Fierobsessed84/EV_VCM_1/Fiero Tesla Wiring.xlsx

Sheet: Sheet1
Tesla Motor |  | With Open Inverter Logic Board | Proposed wiring
1 | IGN +12V |  | Switched IGN
2 | BRAKE ON |  | N/C
3 | PRECHARGE RELAY |  | Green #6 - on contactor box
4 | CAN HIGH |  | To VCU
5 | CAN LOW |  | To VCU
6 | MAIN CONTACTOR |  | White #7 - on contactor box
7 | FORWARD |  | N/C
8 | REVERSE |  | N/C
9 | ENC +5V |  | Red #4 on Encoder
10 | ENC A |  | White #2 on Encoder
11 | GND |  | Chassis GND
12 | ACCEL 5V |  | N/C
13 | ACCEL INPUT |  | N/C
14 | BRAKE TRANSDUCER |  | N/C
15 | ACCEL GND |  | N/C
16 | ENC B |  | Black #3 on Encoder
17 | ENC GND |  | Black #1 on Encoder
18 | ENC SHIELD |  | Bare shield ends at encoder
19 | LINKED IN THE AMPSEAL SOCKET TO PIN 4 |  | #3 on DC/DC
20 | LINKED IN THE AMPSEAL SOCKET TO PIN 5 |  | #2 on DC/DC
21 | CRUISE IN |  | N/C
22 | ACCEL GND |  | N/C
23 | START |  | N/C
Encoder
1 | Encoder Ground |  | #17 on Drive Unit
2 | Encoder A signal |  | #10 on Drive Unit
3 | Encoder B signal |  | #16 on Drive Unit
4 | Encoder +5V |  | #9 on Drive Unit
Tesla Charger
1 | OUT B+
2 | OUT B-
3 | OUT B+
4 | OUT B-
5 | OUT B+
6 | OUT B-
1 | IN N1
2 | IN L1
3 | IN N2
4 | IN L2
5 | IN N3
6 | IN L3
X046
A1 | OUT 2
A2 | OUT 3
A3 | IN 1 | Connect to 12V | +12V Battery | need to check draw to see if it can stay here or be part of the wake up
A4 | IN3
A5
A6 | OUT 1
A7 | CONT1 |  | #5 yellow on Contactor box
A8 | N/C
A9 | CONT2
A10 | IN 2
X042
B1 | 12V | Connect to 12V | +12V Battery | need to check draw to see if it can stay here or be part of the wake up
B2 | Latch EN | N/C internally, so it does nothing | N/C
B3 | CAN_L3 |  | N/C
B4 | CAN H |  | #8 on DC-DC
B5 | Control Pilot | Connect to charge port | Charge port
B6 | FC CAN |  | N/C
B7 | Ground | Connect to ground | Chassis Ground
B8 | CAN_H3 |  | N/C
B9 |  |  | N/C
B10 | CAN L | Pin 7 | #7 on DC-DC
B11 | EVSE Prox | Connect to charge port | Charge port
B12 | IN4 |  | N/C
Battery
14V DC-DC
Pin 1 |  | termination resistor | N/C
Pin 2 |  | CAN Low | #20 on Drive Unit
Pin 3 |  | CAN High | #19 on Drive Unit
Pin 4 |  | NC
Pin 5 |  | Ignition | +12V Battery | need to check draw to see if it can stay here or be part of the wake up
Pin 6 |  | termination resistor | N/C
Pin 7 |  | CAN Low (same as pin 2) | #B10 on charger
Pin 8 |  | CAN High (same as pin 3) | #B4 on charger
Pin 9 |  | NC
Pin 10 |  | Accessory (Serial Wake Up) | Serial Wake up | hot on wakeup. Control by VCU
BMW SMG Shifter |  |  |  | Left | Reverse | Neutral | Drive | UP | Down | Right
1 | Pulled LOW in drive, Up |  |  | N/A | N/A | N/A | LOW | LOW | N/A | N/A | pink | Shifter A
2 | Pulled HIGH in drive and down |  |  | N/A | N/A | N/A | HIGH | N/A | HIGH | N/A | orange | Shifter B
3 | Pulled LOW in reverse only |  |  | N/A | LOW | N/A | N/A | N/A | N/A | N/A | yellow | Shifter C
4 | +12V |  |  |  |  |  |  |  |  |  | red
5 | 0V |  |  |  |  |  |  |  |  |  | black
6 | 0V |  |  |  |  |  |  |  |  |  | black
7 | Pulled LOW in Neutral |  |  | N/A | N/A | LOW | N/A | N/A | N/A | N/A | green | Shifter D
8 | Pulled LOW in drive, right, down |  |  | N/A | N/A | N/A | LOW | N/A | LOW | LOW | blue | Shifter E
9 | Pulled HIGH in Reverse |  |  | N/A | HIGH | N/A | N/A | N/A | N/A | N/A | violet | Shifter F
10 | Pulled HIGH in Neutral |  |  | N/A | N/A | HIGH | N/A | N/A | N/A | N/A | grey | Shifter G
11 | +12V |  |  |  |  |  |  |  |  |  | red
12 | Pulled HIGH in Drive, Up, Right |  |  | N/A | N/A | N/A | HIGH | HIGH | N/A | HIGH | white | Shifter H
 | converted to logic
1 | Pulled LOW in drive, Up |  |  | HIGH | HIGH | HIGH | LOW | LOW | HIGH | HIGH | pink | Shifter A
2 | Pulled HIGH in drive and down |  |  | LOW | LOW | LOW | HIGH | LOW | HIGH | LOW | orange | Shifter B
3 | Pulled LOW in reverse only |  |  | HIGH | LOW | HIGH | HIGH | HIGH | HIGH | HIGH | yellow | Shifter C
4 | +12V |  |  |  |  |  |  |  |  |  | red
5 | 0V |  |  |  |  |  |  |  |  |  | black
6 | 0V |  |  |  |  |  |  |  |  |  | black
7 | Pulled LOW in Neutral |  |  | HIGH | HIGH | LOW | HIGH | HIGH | HIGH | HIGH | green | Shifter D
8 | Pulled LOW in drive, right, down |  |  | HIGH | HIGH | HIGH | LOW | HIGH | LOW | LOW | blue | Shifter E
9 | Pulled HIGH in Reverse |  |  | LOW | HIGH | LOW | LOW | LOW | LOW | LOW | violet | Shifter F
10 | Pulled HIGH in Neutral |  |  | LOW | LOW | HIGH | LOW | LOW | LOW | LOW | grey | Shifter G
11 | +12V |  |  |  |  |  |  |  |  |  | red
12 | Pulled HIGH in Drive, Up, Right |  |  | LOW | LOW | LOW | HIGH | HIGH | LOW | HIGH | white | Shifter H
X044 Tesla Charge Port
1 | 12V
2 | Latch Enable |  | Factory Tesla, goes to X042, 2
3 | Can H
4 | Gnd
5 | N/C
6 | Can L
1 | EVSE Pilot | Purple | Factory Tesla, goes to X042, 5
2 | EVSE Prox (330 ohm to 5V in charger) | Orange | Factory Tesla, goes to X042, 11
 | Chassis Ground | Green
Chevy Volt A/C Compressor
1 | Ground
2 | Accessory Wake up Serial Data 2
3 | Run/Crank Ignition 1 Voltage
4 | Battery Positive Voltage
5 | High Speed GMLAN Serial Data (-) (1)
6 | High Speed GMLAN Serial Data (-) (1)
7 | High Speed GMLAN Serial Data (+) (1)
8 | High Speed GMLAN Serial Data (+) (1)
relay box
1 | +12V Contactor control feed | blue
2 | +12V Board power | red
3 | 0V Board power | black
4 | - Main Contactor control | purple
5 | +/- Accessory Contactors control | yellow | #A7 on charger
6 | + Precharge Contactor control | green | #3 on Drive unit
7 | + Main Contactor control | white | #6 on Drive unit
8 | 0V Contactor control common | brown
Coolant Pumps | OEM Connector: 09408621 | 13579713 | battery pump
1 | Motor Enable | 13579713 | motor pump
2 | Motor Feedback Signal | 13579710 | hvac pump
3 | Motor Control |  | They're all pretty much the same, I cant tell whats different.
4 | Ground
5 | Battery Positive Voltage
OEM Connector: 33472-0601 Service Connector: 19178087
heater coolant control valve
1 | Battery Positive Voltage
2 | Heater Solenoid Valve Control
3 | 5 Volt Reference
4 | Coolant Valve Position Sensor Signal
5 | Low Reference
6 | Ground
OEM Connector: 33472-0611 Service Connector: 19178087
battery coolant control valve
1 | Motor High Control | runs fine on 12V. Has end of travel stops in both positions.
2 | Motor Low Control | Amperage when moving is ~.10 end of travel is ~.60 at 12V, dead stop.
3 | N/C
4 | Sensor Signal
5 | Low Reference
6 | Sensor High Reference | Uses a traditional 10k pot, ends of travel seem to be around 3-6k.
 | spal fan 30107089 looks promising
 | could just use chevy volt fan though. But its big

Sheet: VCM
Field Pin | Description | Type | Teensy Pin # | Teensy pin label | Teensy Pin alternates | Int or ext | Field interface | proposed field terminal | Notes
30 | canbus 1 rx | dedicated | 0 | CRX2 | DI/O, RX1, CS1, CRX2, PWM | EXT | SN65HVD234D | 1
2 | canbus 1 tx | dedicated | 1 | CTX2 | DI/O, TX1, MISO1, CTX2, PWM | EXT | SN65HVD234D | 2
4 | Shifter_a | digital input | 2 | DI/O | DI/O, PWM | EXT | 10k to 3.3v | 3 | Pulled up input, shifter grounds for signal
32 | Shifter_b | digital input | 3 | DI/O | DI/O, PWM | EXT | in to 51k to pin to 10k to 0V | 4 | 12V digital signal, reduce to 3.3v.
5 | Shifter_c | digital input | 4 | DI/O | DI/O, PWM | EXT | 10k to 3.3v | 5 | Pulled up input, shifter grounds for signal
33 | Shifter_d | digital input | 5 | DI/O | DI/O, PWM | EXT | 10k to 3.3v | 6 | Pulled up input, shifter grounds for signal
6 | Shifter_e | digital input | 6 | DI/O | DI/O, PWM | EXT | 10k to 3.3v | 7 | Pulled up input, shifter grounds for signal
34 | Shifter_f | digital input | 7 | DI/O | DI/O, RX2, PWM | EXT | in to 51k to pin to 10k to 0V | 8 | 12V digital signal, reduce to 3.3v.
7 | Shifter_g | digital input | 8 | DI/O | DI/O, TX2, PWM | EXT | in to 51k to pin to 10k to 0V | 9 | 12V digital signal, reduce to 3.3v.
35 | Shifter_h | digital input | 9 | DI/O | DI/O, PWM | EXT | in to 51k to pin to 10k to 0V | 10 | 12V digital signal, reduce to 3.3v.
36 | Coolant pump 1 | PWM output | 10 | PWM | DI/O, CS, PWM | EXT | ULN2003ADR | 11 | 10k to 5v on output from the transister array. This will give us drive signal
9 | Coolant pump 2 | PWM output | 11 | PWM | DI/O, MOSI, CTX1, PWM | EXT | ULN2003ADR | 12 | 1khz PWM signal, 12V-0V. 90% is low, 10% is full.
37 | Coolant pump 3 | PWM output | 12 | PWM | DI/O, MISO, PWM | EXT | ULN2003ADR | 13 | 1khz PWM signal, 12V-0V. 90% is low, 10% is full.
 | led | digital output | 13 | DI/O | DI/O, LED, SCK, PWM | INT | 402 ohm to LED |  | Here to say hello
 | Coolant Diverter Pos (mode) | analog input | 14 | A0 | DI/O, A0, TX3, PWM | EXT | in to 33k to pin to 10k to 0V | 14 | 1khz PWM signal, 5V-0V 10k to 12v on array output to give us signal
 | Coolant diverter Pos (battery) | analog input | 15 | A1 | DI/O, A1, RX3, PWM | EXT | in to 33k to pin to 10k to 0V | 15 | 1khz PWM signal, 5V-0V
 | ESP8622 | dedicated | 16 | RX4 | DI/O, A2, RX4, SCL1 | INT | ESP8622 |  | wifi module
 | ESP8622 | dedicated | 17 | TX4 | DI/O, A3, TX4, SDA1 | INT | ESP8622 |  | wifi module
 | accelerometer data/ I/O EXT | dedicated | 18 | SDA | DI/O, A4, SDA, PWM | INT | MCP6050/MCP23017-X_SS |  | Internal to the board, goes to both chips
 | accelerometer clock/ I/O EXT | dedicated | 19 | SCL | DI/O, A5, SCL, PWM | INT | MCP6050/MCP23017-X_SS |  | Internal to the board, goes to both chips
 | ac high press | analog input | 20 | A6 | DI/O, A6, TX5 | EXT | in to 33k to pin to 10k to 0V | 16 | 5V signal redcution to 3.3v tolerant
 | ac low press | analog input | 21 | A7 | DI/O, A7, RX5 | EXT | in to 33k to pin to 10k to 0V | 17 | 5V signal redcution to 3.3v tolerant
 | canbus 0 tx | dedicated | 22 | CTX1 | DI/O, A8, CRX1, PWM | EXT | SN65HVD234D | 18
 | canbus 0 rx | dedicated | 23 | CRX1 | DI/O, A9, CTX1, PWM | EXT | SN65HVD234D | 19
 | condenser temp | analog input | 24 | A10 | DI/O, A10, TX6, SCL2, PWM | EXT | Pulled up resistor | 20
 | evap temp | analog input | 25 | A11 | DI/O, A11, RX6, SDA2, PWM | EXT | Pulled up resistor | 21
 | ambient temp | analog input | 26 | A12 | DI/O, A12, MOSI1 | EXT | Pulled up resistor | 22
 | accy voltage | analog input | 27 | A13 | DI/O, SCK1 | INT | in to 51k to pin to 10k to 0V
 | Coolant diverter (mode) | digital output | 28 | PWM | DI/O, RX7, PWM | EXT | TB6612FNG,C,8,EL | 23 | Coolant diverter valve control PWM
 | Coolant diverter (battery) | digital output | 29 | PWM | DI/O, TX7, PWM | EXT | TB6612FNG,C,8,EL | 24 | Coolant diverter valve control PWM
 | canbus 2 rx | dedicated | 30 | CRX3 | DI/O, CTX3 | EXT | SN65HVD234D | 25 | terminated bus
 | canbus 2 tx | dedicated | 31 | CTX3 | DI/O, CRX3 | EXT | SN65HVD234D | 26 | terminated bus
 | dc_dc_hv_on | digital output | 32 | DI/O | DI/O | EXT | NCV8401ADTRKG | 27 | pulls to ground when active
 | car_on_override | digital output | 33 | DI/O | DI/O, PWM | EXT | NCV8401ADTRKG | 28 | pulls to ground when active
 | Accessory_hv_on | digital output | 34 | DI/O | DI/O, RX8 | EXT | NCV8401ADTRKG | 29 | pulls to ground when active
 | A/C requested | digital input | 35 | DI/O | DI/O, TX8 | EXT | in to 51k to pin to 10k to 0V | 30 | 12V digital signal, reduce to 3.3v.
 | Coolant fan 1 | PWM output | 36 | PWM | DI/O, CS, PWM | EXT | ULN2003ADR | 31
 | Coolant fan 2 | PWM output | 37 | PWM | DI/O, CS, PWM | EXT | ULN2003ADR | 32 | 1khz PWM signal, 5V-0V
 | aps1 | analog input | 38 | A14 | DI/O, A14, CS1 | EXT | in to 0R to pin to 10k to 0V | 33 | needs no reduction, but we'll put a pad with a 0R in just to make it universal
 | aps2 | analog input | 39 | A15 | DI/O, A15, MISO1 | EXT | in to 33k to pin to 10k to 0V | 34 | 5V signal redcution to 3.3v tolerant
 | rps1 | analog input | 40 | A16 | DI/O, A16 | EXT | TBD in to 33k to pin to 10k to 0V | 35 | 5V signal redcution to 3.3v tolerant
 | rps2 | analog input | 41 | A17 | DI/O, A17 | EXT | TBD in to 33k to pin to 10k to 0V | 36 | 5V signal redcution to 3.3v tolerant
1 | Can 0 High
29 | Can 0 Low
2 | Can 1 High
30 | Can 1 Low
3 | Can 2 High
31 | Can 2 Low
4 | Shifter a
32 | Shifter b
5 | Shifter c
33 | Shifter d
6 | Shifter e
34 | Shifter f
7 | Shifter g
35 | Shifter h
8 | A/C requested
36 | Coolant pump 1
9 | Coolant pump 2
37 | Coolant pump 3
10 | Coolant fan 1
38 | Coolant fan 2
11 | Radiator Coolant Valve + Control
39 | Radiator Coolant Valve - Control
12 | Battery Coolant Valve + Control
40 | Battery Coolant Valve - Control
13 | +12v accessory
41 | +12v battery
14 | GND
42 | GND
15 | GND
43 | Condensor temp
16 | Evaporator temp
44 | Ambient temp
17 | +5 analog feed
45 | APS 1
18 | RPS 1
46 | GND
19 | +5 analog feed
47 | APS 2
20 | RPS 2
48 | GND
21 | +5 analog feed
49 | Radiator Coolant Valve Position
22 | Battery Coolant Valve Position
50 | GND
23 | +5 analog feed
51 | A/C Pressure High
24 | A/C Pressure Low
52 | GND
25 | Shifter unlock
53 | Cruise on
26 | Cruise accel
54 | Cruise coast
27 | brake
55 | DC/DC Power on
28 | Car on override
56 | Accessory HV on
