Fierobsessed84/EV_VCM_1/(list of files, drawings)

Other design files:
EV main V2.pcb
EV main.pcb
